Kaoru-dev/Wireless-Charging-Car-with-Acoustic-Source-Localization/Circuit/Overall Plan.png

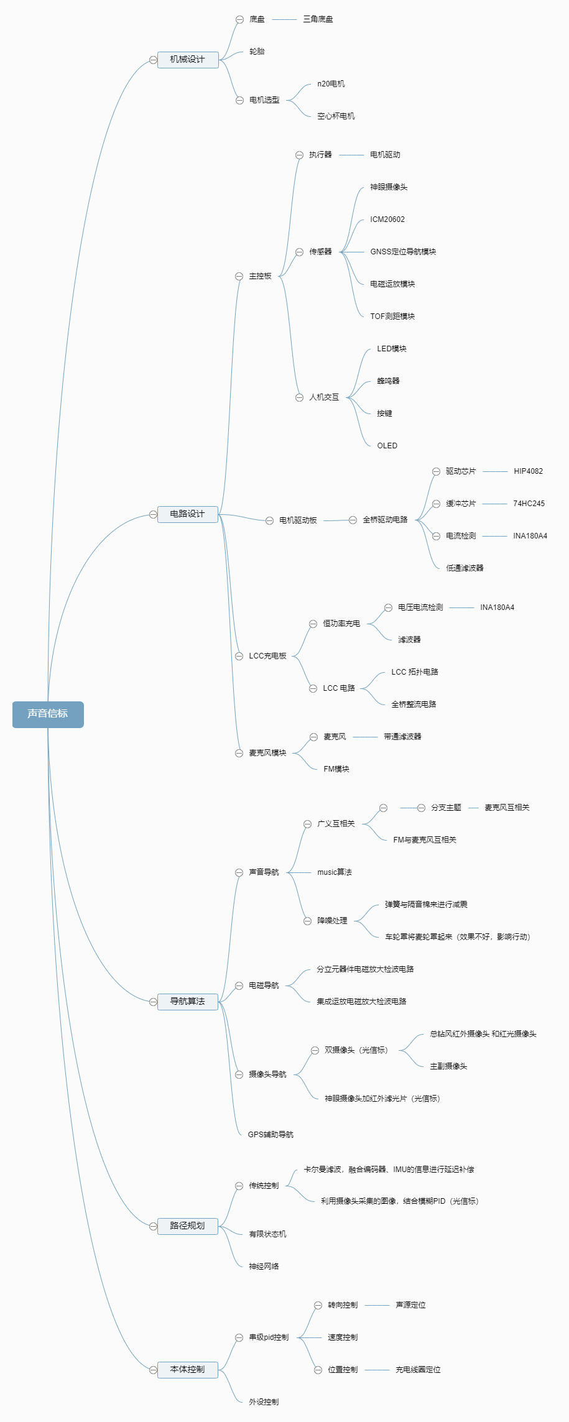
Circuit/Overall Plan.png
