Kaoru-dev/Wireless-Charging-Car-with-Acoustic-Source-Localization/Circuit/Power Tree.jpg

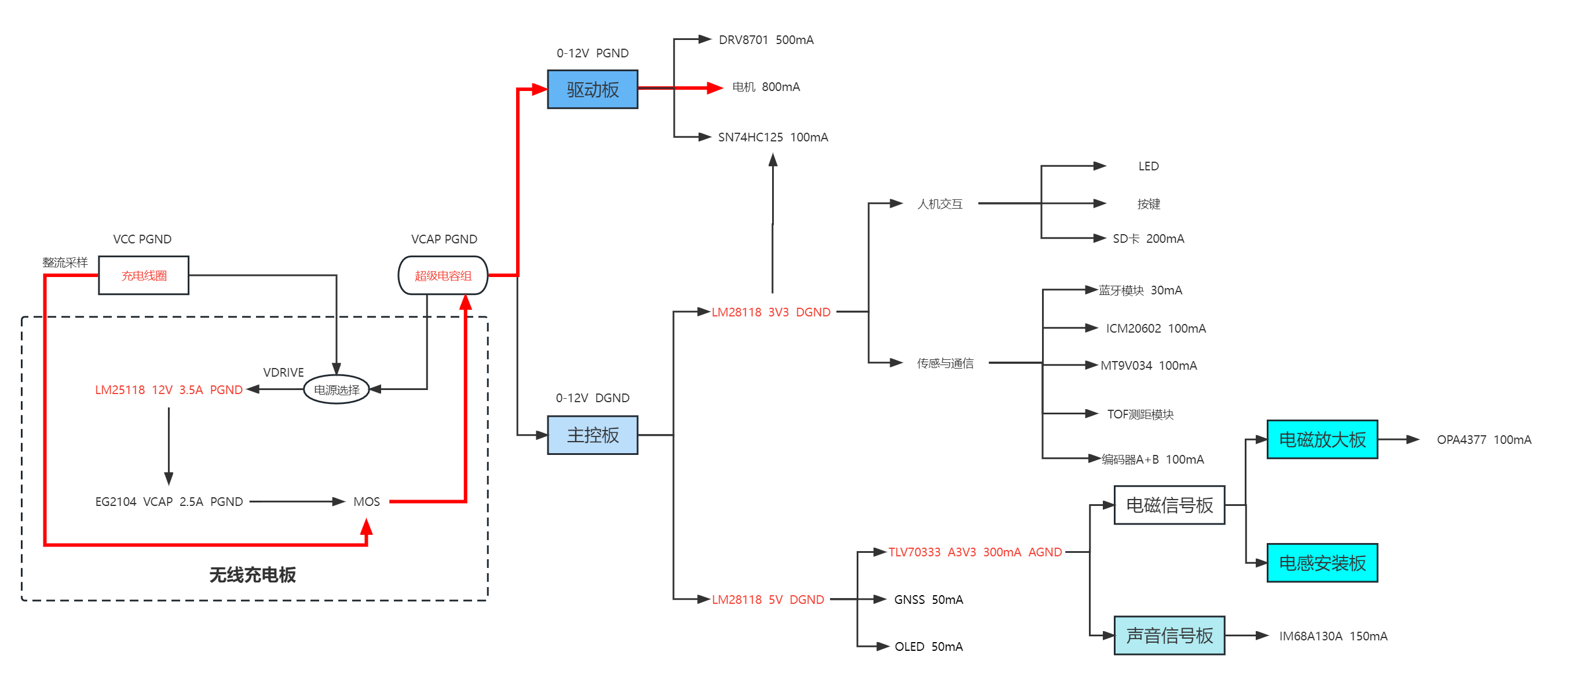
Circuit/Power Tree.jpg
