Kaoru-dev/Wireless-Charging-Car-with-Acoustic-Source-Localization/Circuit/Shopping List.xlsx

序号 | 名称 | 型号 | 数量 | 单价 | 链接
1 | TOF测距模块 | DL1A测距模块 | 1 | 29 | https://m.tb.cn/h.U9poPIz?tk=ThkYd4PU1Mo
2 | 姿态传感器 | ICM20602 | 1 | 44 | https://m.tb.cn/h.Uko7qX3?tk=yhjvd4Pl1Zu
3 | 定位导航模块 | 双频GNSS定位导航模块 | 1 | 102 | https://m.tb.cn/h.U9pCinX?tk=7lQYd4PlLZR
4 | 摄像头 | MT9V034神眼摄像头 | 1 | 236.9 | https://m.tb.cn/h.UQE8dhS?tk=eBLld4PLWfk
5 | 蓝牙模块 | 沁恒USB转蓝牙串口 | 1 | 93.7 | https://m.tb.cn/h.UQEQsiv?tk=FVXjd4PKQzA
6 | 蜂鸣器 | 有源蜂鸣器 | 1 | 2.7 | https://m.tb.cn/h.UQE9Hgt?tk=DK0fd4PqPnV
7 | OLED | 3V3黄蓝OLED模块 | 1 | 27.7 | https://m.tb.cn/h.UQYiOSg?tk=ajaHd4PJ3u1
8 | 电机套装 | 直流霍尔编码减速电机 | 2 | 38 | https://m.tb.cn/h.UkoLofJ?tk=c3Kbd4PsRHU
9 | 编码器 | 龙邱512线mini编码器 | 2 | 170.8 | https://m.tb.cn/h.UQY9usL?tk=fcwld4PHyrk
