Kaoru-dev/Wireless-Charging-Car-with-Acoustic-Source-Localization/Circuit/Wiring Diagram.jpg

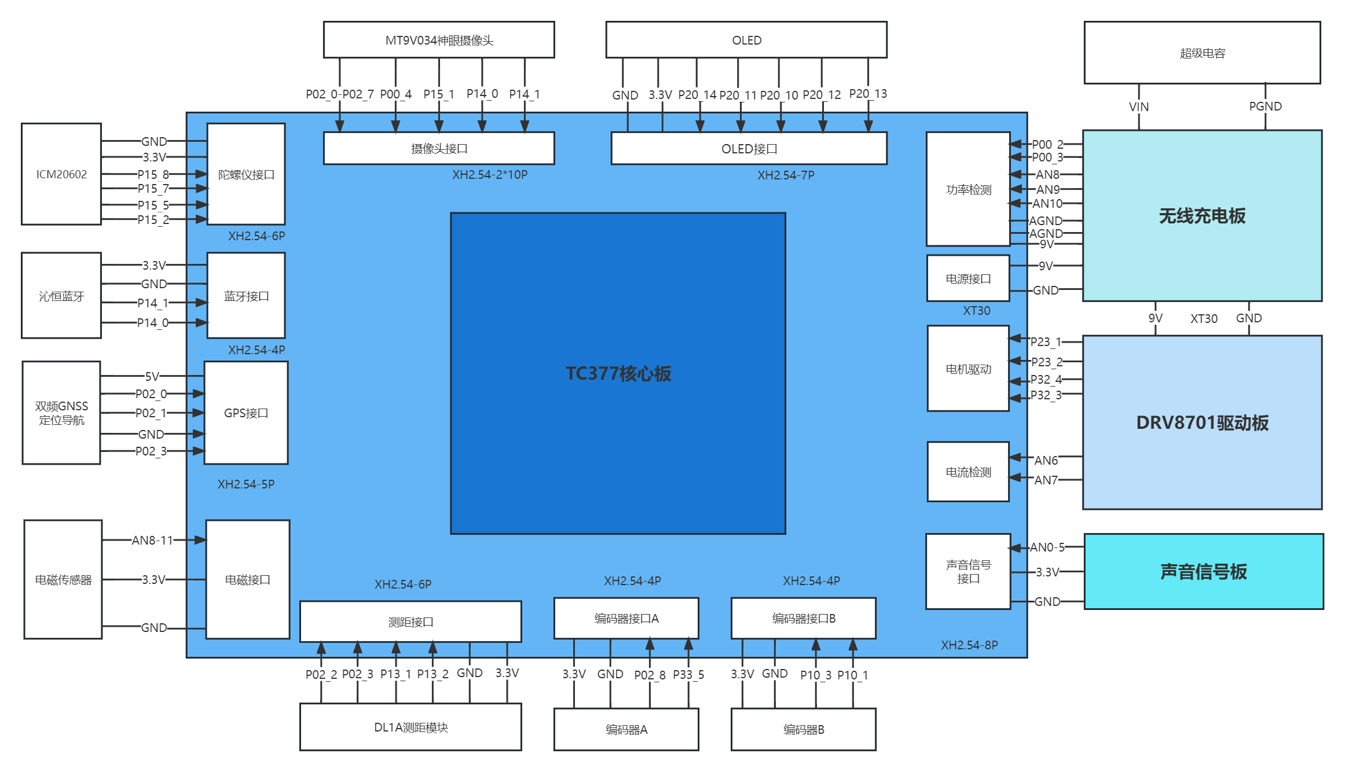
Circuit/Wiring Diagram.jpg
