Kaoru-dev/Wireless-Charging-Car-with-Acoustic-Source-Localization/(list of files, drawings)

Other design files:
Circuit/Circuit Design/Charging circuit board/Beacon_Receive.PcbLib
Circuit/Circuit Design/Charging circuit board/Beacon_Receive.SchLib
Circuit/Circuit Design/Charging circuit board/Constant Power Charging Board/Constant Power Charging Board 4.5.PcbDoc
Circuit/Circuit Design/Charging circuit board/Constant Power Charging Board/Constant Power Charging Board 4.5.SchDoc
Circuit/Circuit Design/Charging circuit board/Constant Power Charging Board/Constant Power Charging Board.PcbLib
Circuit/Circuit Design/Charging circuit board/Constant Power Charging Board/Constant Power Charging Board.SchLib
Circuit/Circuit Design/Charging circuit board/LCC Resonant Charging Board/LCC Resonant Charging Board.PcbDoc
Circuit/Circuit Design/Charging circuit board/LCC Resonant Charging Board/LCC Resonant Charging Board.SchDoc
Circuit/Circuit Design/Controller-Driver Integrated Board/Controller-Driver Integrated Board/Controller-Driver Integrated Board.PrjPcb
Circuit/Circuit Design/Controller-Driver Integrated Board/Integrated_Main_Driver_Board 1.5.SchDoc
Circuit/Circuit Design/Controller-Driver Integrated Board/Integrated_Main_Driver_Board-01-Minimum System Circuit-20230110.SchDoc
Circuit/Circuit Design/Controller-Driver Integrated Board/Integrated_Main_Driver_Board-02-Sensor Circuit-20230110.SchDoc
Circuit/Circuit Design/Controller-Driver Integrated Board/Integrated_Main_Driver_Board-03-Motor Driver Circuit-20230110.SchDoc
Circuit/Circuit Design/Controller-Driver Integrated Board/Integrated_Main_Driver_Board-04-Debug & Communication Circuit-20230110.SchDoc
Circuit/Circuit Design/Controller-Driver Integrated Board/Integrated_Main_Driver_Board-05-Wireless Charging Circuit-20230110.SchDoc
Circuit/Circuit Design/Controller-Driver Integrated Board/Integrated_Main_Driver_Board-06-Power Supply Circuit -20230110.SchDoc
Circuit/Circuit Design/Controller-Driver Integrated Board/Main Control Board.PcbLib
Circuit/Circuit Design/Controller-Driver Integrated Board/Main Control Board.SchLib
Circuit/Circuit Design/Electromagnetic navigation circuit board/Electromagnetic Detection Board/Electromagnetic Detection Board.PcbDoc
Circuit/Circuit Design/Electromagnetic navigation circuit board/Electromagnetic Detection Board/Electromagnetic Detection Board.SchDoc
Circuit/Circuit Design/Electromagnetic navigation circuit board/Electromagnetic Op-Amp Board/Electromagnetic Op-Amp Board.PcbDoc
Circuit/Circuit Design/Electromagnetic navigation circuit board/Electromagnetic Op-Amp Board/Electromagnetic Op-Amp Board.PcbLib
Circuit/Circuit Design/Electromagnetic navigation circuit board/Electromagnetic Op-Amp Board/Electromagnetic Op-Amp Board.SchDoc
Circuit/Circuit Design/Electromagnetic navigation circuit board/Electromagnetic Op-Amp Board/Electromagnetic Op-Amp Board.SchLib
Circuit/Circuit Design/Power supply circuit board/3V-16V to 5V3A DC-DC Converter/3V-16V to 5V3A DC-DC Converter.PcbDoc
Circuit/Circuit Design/Power supply circuit board/3V-16V to 5V3A DC-DC Converter/3V-16V to 5V3A DC-DC Converter.SchDoc
Circuit/Circuit Design/Power supply circuit board/5V-25V to 12V3A DC-DC Converter/5V-25V to 12V3A DC-DC Converter.PcbDoc
Circuit/Circuit Design/Power supply circuit board/5V-25V to 12V3A DC-DC Converter/5V-25V to 12V3A DC-DC Converter.SchDoc
Circuit/Circuit Design/Sound signal circuit board/Adapter board/Adapter board.PcbDoc
Circuit/Circuit Design/Sound signal circuit board/Adapter board/Adapter board.SchDoc
Circuit/Circuit Design/Sound signal circuit board/MEMS Microphone Module/LQ68A130V1.PcbLib
Circuit/Circuit Design/Sound signal circuit board/MEMS Microphone Module/LQ68A130V1.SCHLIB
Circuit/Circuit Design/Sound signal circuit board/MEMS Microphone Module/MEMS Microphone Module.PcbDoc
Circuit/Circuit Design/Sound signal circuit board/MEMS Microphone Module/MEMS Microphone Module.SchDoc
