Kaoru-dev/Wireless-Charging-Car-with-Acoustic-Source-Localization/Code/src/AppSw/Tricore/APP/LQ_Atom_Motor.h

/*LLLLLLLLLLLLLLLLLLLLLLLLLLLLLLLLLLLLLLLLLLLLLLLLLLLLLLLLLLLLLL
【平    台】北京龙邱智能科技TC3xxxA核心板
【编    写】chiusir
【E-mail】chiusir@163.com
【软件版本】V1.1 版权所有，单位使用请先联系授权
【最后更新】2020年10月28日
【相关信息参考下列地址】
【网    站】http://www.lqist.cn
【淘宝店铺】http://longqiu.taobao.com
------------------------------------------------
【dev.env.】AURIX Development Studio1.2.2及以上版本
【Target 】 TC3xxxA
【Crystal】 20.000Mhz
【SYS PLL】 300MHz
________________________________________________________________
基于iLLD_1_0_1_11_0底层程序,
使用例程的时候，建议采用没有空格的英文路径，
=================================================================
程序配套视频地址：https://space.bilibili.com/95313236
QQQQQQQQQQQQQQQQQQQQQQQQQQQQQQQQQQQQQQQQQQQQQQQQQQQQQQQQQQQQQQQ*/
#ifndef __LQ_MT_H_
#define __LQ_MT_H_

#define ATOMSERVO1       IfxGtm_ATOM2_0_TOUT32_P33_10_OUT
#define ATOMSERVO2       IfxGtm_ATOM2_5_TOUT35_P33_13_OUT

//#define ATOMPWM0Pin         IfxGtm_ATOM0_2_TOUT107_P10_5_OUT //定义PWM输出管脚，通过P10.5输出PWM控制蓝灯呼吸
#define ATOMPWM0         IfxGtm_ATOM0_6_TOUT42_P23_1_OUT
#define ATOMPWM1         IfxGtm_ATOM0_5_TOUT40_P32_4_OUT
#define ATOMPWM2         IfxGtm_ATOM0_0_TOUT53_P21_2_OUT
#define ATOMPWM3         IfxGtm_ATOM0_4_TOUT50_P22_3_OUT
#define ATOMPWM4         IfxGtm_ATOM0_2_TOUT33_P33_11_OUT
//#define ATOMPWM4         IfxGtm_ATOM0_2_TOUT55_P21_4_OUT
#define ATOMPWM5         IfxGtm_ATOM0_1_TOUT54_P21_3_OUT
#define ATOMPWM6         IfxGtm_ATOM0_7_TOUT64_P20_8_OUT
#define ATOMPWM7         IfxGtm_ATOM0_3_TOUT56_P21_5_OUT

void LQ_Atom_Motor_8chPWM(void);
void LQ_ATom_Servo_2chPWM(void);
void LQ_Atom_8chPWM(void);

#endif
