Kaoru-dev/Wireless-Charging-Car-with-Acoustic-Source-Localization/Code/src/AppSw/Tricore/APP/LQ_OLED096.c

/*LLLLLLLLLLLLLLLLLLLLLLLLLLLLLLLLLLLLLLLLLLLLLLLLLLLLLLLLLLLLLL
【平    台】北京龙邱智能科技TC3xxxA核心板
【编    写】chiusir
【E-mail】chiusir@163.com
【软件版本】V1.1 版权所有，单位使用请先联系授权
【最后更新】2020年10月28日
【相关信息参考下列地址】
【网    站】http://www.lqist.cn
【淘宝店铺】http://longqiu.taobao.com
------------------------------------------------
【dev.env.】AURIX Development Studio1.2.2及以上版本
【Target 】 TC3xxxA
【Crystal】 20.000Mhz
【SYS PLL】 300MHz
________________________________________________________________
基于iLLD_1_0_1_11_0底层程序,
使用例程的时候，建议采用没有空格的英文路径，
=================================================================
程序配套视频地址：https://space.bilibili.com/95313236
QQQQQQQQQQQQQQQQQQQQQQQQQQQQQQQQQQQQQQQQQQQQQQQQQQQQQQQQQQQQQQQ*/

#include <LQ_GPIO.h>
#include <LQ_STM.h>
#include <LQ_OLED096.h>
#include "include.h"
//龙邱OLED SPI口模块管脚顺序
#define OLED_CK    P20_14     //OLED CK管脚
#define OLED_DI	   P20_11     //OLED DI管脚
#define OLED_RST   P20_10     //OLED RST管脚
#define OLED_DC	   P20_12     //OLED DC管脚
#define OLED_CS	   P20_13     //OLED CS管脚 默认拉低，可以不用

#define OLED_DC_H  PIN_Write(OLED_DC, 1);
#define OLED_DC_L  PIN_Write(OLED_DC, 0);

#define OLED_RST_H PIN_Write(OLED_RST, 1);
#define OLED_RST_L PIN_Write(OLED_RST, 0);

#define OLED_DI_H  PIN_Write(OLED_DI, 1);
#define OLED_DI_L  PIN_Write(OLED_DI, 0);

#define OLED_CK_H  PIN_Write(OLED_CK, 1);
#define OLED_CK_L  PIN_Write(OLED_CK, 0);


#define X_WIDTH 132
#define Y_WIDTH 64

/*!
  * @brief    OLED初始化
  *
  * @param    无
  *
  * @return   无
  *
  * @note     如果修改管脚 需要修改初始化的管脚 
  *
  * @see      OLED_Init();
  *
  * @date     2019/6/13 星期四
  */
void OLED_Init(void)
{ 
    PIN_InitConfig(OLED_DC, PIN_MODE_OUTPUT, 0);
    PIN_InitConfig(OLED_RST, PIN_MODE_OUTPUT, 0);
	PIN_InitConfig(OLED_DI, PIN_MODE_OUTPUT, 0);
	PIN_InitConfig(OLED_CK, PIN_MODE_OUTPUT, 0);
	PIN_InitConfig(OLED_CS, PIN_MODE_OUTPUT, 0);
    
	OLED_CK_H;
    //OLED_CS=1;	//预制SLK和SS为高电平
	OLED_RST_L;
    delayms(50);
    OLED_RST_H;
    
    OLED_WrCmd(0xae);//--turn off oled panel
    OLED_WrCmd(0x00);//---set low column address
    OLED_WrCmd(0x10);//---set high column address
    OLED_WrCmd(0x40);//--set start line address  Set Mapping RAM Display Start Line (0x00~0x3F)
    OLED_WrCmd(0x81);//--set contrast control register
    OLED_WrCmd(0xcf); // Set SEG Output Current Brightness
    OLED_WrCmd(0xa1);//--Set SEG/Column Mapping     0xa0左右反置 0xa1正常
    OLED_WrCmd(0xc8);//Set COM/Row Scan Direction   0xc0上下反置 0xc8正常
    OLED_WrCmd(0xa6);//--set normal display
    OLED_WrCmd(0xa8);//--set multiplex ratio(1 to 64)
    OLED_WrCmd(0x3f);//--1/64 duty
    OLED_WrCmd(0xd3);//-set display offset	Shift Mapping RAM Counter (0x00~0x3F)
    OLED_WrCmd(0x00);//-not offset
    OLED_WrCmd(0xd5);//--set display clock divide ratio/oscillator frequency
    OLED_WrCmd(0x80);//--set divide ratio, Set Clock as 100 Frames/Sec
    OLED_WrCmd(0xd9);//--set pre-charge period
    OLED_WrCmd(0xf1);//Set Pre-Charge as 15 Clocks & Discharge as 1 Clock
    OLED_WrCmd(0xda);//--set com pins hardware configuration
    OLED_WrCmd(0x12);
    OLED_WrCmd(0xdb);//--set vcomh
    OLED_WrCmd(0x40);//Set VCOM Deselect Level
    OLED_WrCmd(0x20);//-Set Page Addressing Mode (0x00/0x01/0x02)
    OLED_WrCmd(0x02);//
    OLED_WrCmd(0x8d);//--set Charge Pump enable/disable
    OLED_WrCmd(0x14);//--set(0x10) disable
    OLED_WrCmd(0xa4);// Disable Entire Display On (0xa4/0xa5)
    OLED_WrCmd(0xa6);// Disable Inverse Display On (0xa6/a7)
    OLED_WrCmd(0xaf);//--turn on oled panel
    OLED_CLS();      //初始清屏
    OLED_Set_Pos(0,0);
    
} 
/** 6*8字库  */
const unsigned char F6x8[][6] =
{
    { 0x00, 0x00, 0x00, 0x00, 0x00, 0x00 },   // sp
    { 0x00, 0x00, 0x00, 0x2f, 0x00, 0x00 },   // !
    { 0x00, 0x00, 0x07, 0x00, 0x07, 0x00 },   // "
    { 0x00, 0x14, 0x7f, 0x14, 0x7f, 0x14 },   // #
    { 0x00, 0x24, 0x2a, 0x7f, 0x2a, 0x12 },   // $
    { 0x00, 0x62, 0x64, 0x08, 0x13, 0x23 },   // %
    { 0x00, 0x36, 0x49, 0x55, 0x22, 0x50 },   // &
    { 0x00, 0x00, 0x05, 0x03, 0x00, 0x00 },   // '
    { 0x00, 0x00, 0x1c, 0x22, 0x41, 0x00 },   // (
    { 0x00, 0x00, 0x41, 0x22, 0x1c, 0x00 },   // )
    { 0x00, 0x14, 0x08, 0x3E, 0x08, 0x14 },   // *
    { 0x00, 0x08, 0x08, 0x3E, 0x08, 0x08 },   // +
    { 0x00, 0x00, 0x00, 0xA0, 0x60, 0x00 },   // ,
    { 0x00, 0x08, 0x08, 0x08, 0x08, 0x08 },   // -
    { 0x00, 0x00, 0x60, 0x60, 0x00, 0x00 },   // .
    { 0x00, 0x20, 0x10, 0x08, 0x04, 0x02 },   // /
    { 0x00, 0x3E, 0x51, 0x49, 0x45, 0x3E },   // 0
    { 0x00, 0x00, 0x42, 0x7F, 0x40, 0x00 },   // 1
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
};

/*!
  * @brief    简单延时函数
  *
  * @param    Del_1ms ：延时时间
  *
  * @return   无
  *
  * @note     无
  *
  * @see      lq_oled_short_delay(1);
  *
  * @date     2019/6/13 星期四
  */
void lq_oled_short_delay(unsigned int Del)	//
{
  while(Del--)
  {
	  __asm("NOP");

  }
}
/*!
  * @brief    OLED画点命令
  *
  * @param    data ：要画的点
  *
  * @return   无
  *
  * @note     无
  *
  * @see      内部调用
  *
  * @date     2019/6/13 星期四
  */
void OLED_WrDat(unsigned char data)
{
    unsigned char i=8;
    //OLED_CS=0;;
    OLED_DC_H;;
    OLED_CK_L;;
    lq_oled_short_delay(1);
    while(i--)
    {
        if(data&0x80){OLED_DI_H;}
        else{OLED_DI_L;}
        OLED_CK_H;
        lq_oled_short_delay(1);
        //asm("nop");            
        OLED_CK_L;
        data<<=1;    
    }
    //OLED_CS=1;
}

/*!
  * @brief    OLED命令
  *
  * @param    cmd ：命令
  *
  * @return   无
  *
  * @note     无
  *
  * @see      内部调用
  *
  * @date     2019/6/13 星期四
  */
void OLED_WrCmd(unsigned char cmd)
{
    unsigned char i=8;
    
    //OLED_CS=0;;
    OLED_DC_L;
    OLED_CK_L;
    lq_oled_short_delay(1);
    while(i--)
    {
        if(cmd&0x80){OLED_DI_H;}
        else{OLED_DI_L;}
        OLED_CK_H;
        lq_oled_short_delay(1);
        OLED_CK_L;
        cmd<<=1;
    } 	
    //OLED_CS=1;
}

/*!
  * @brief    OLED设置点
  *
  * @param    x ：坐标   
  * @param    y ：坐标
  *
  * @return   无
  *
  * @note     左上角为0,0  右下角 127,63
  *
  * @see      内部调用
  *
  * @date     2019/6/13 星期四
  */
void OLED_Set_Pos(unsigned char x, unsigned char y)
{ 
    OLED_WrCmd(0xb0+y);
    OLED_WrCmd(((x&0xf0)>>4)|0x10);
    OLED_WrCmd((x&0x0f));
} 

/*!
  * @brief    OLED全亮
  *
  * @param    无   
  *
  * @return   无
  *
  * @note     无
  *
  * @see      OLED_Fill(); //OLED全亮 用于检测坏点
  *
  * @date     2019/6/13 星期四
  */
void OLED_Fill(void)
{
    unsigned char y,x;
    
    for(y=0;y<8;y++)
    {
        OLED_WrCmd(0xb0+y);
        OLED_WrCmd(0x01);
        OLED_WrCmd(0x10);
        for(x=0;x<X_WIDTH;x++)
            OLED_WrDat(0xff);
    }
}

/*!
  * @brief    OLED清屏
  *
  * @param    无  
  *
  * @return   无
  *
  * @note     无
  *
  * @see      OLED_CLS(); //清屏
  *
  * @date     2019/6/13 星期四
  */
void OLED_CLS(void)
{
    unsigned char y,x;	
    for(y=0;y<8;y++)
    {
        OLED_WrCmd(0xb0+y);
        OLED_WrCmd(0x01);
        OLED_WrCmd(0x10);
        for(x=0;x<X_WIDTH;x++)
            OLED_WrDat(0);
    }
}



/*!
  * @brief    画一个点
  *
  * @param    x  : 0-127 
  * @param    y  : 0-63
  *
  * @return   无
  *
  * @note     OLED是按字节显示的 一个字节8位，代表8个纵向像素点，
  * @note     因此如果画点 OLED_PutPixel(0,0); OLED_PutPixel(0,1); 只会显示点(0, 1) (0,0)则在画点(0,1)时清除掉
  *
  * @see      OLED_PutPixel(0, 0); //画一个点 左上角为0,0  右下角 127,63
  *
  * @date     2019/6/13 星期四
  */
void OLED_PutPixel(unsigned char x,unsigned char y)
{
    unsigned char data1;  //data1当前点的数据 
    
    OLED_Set_Pos(x,(unsigned char)(y>>3));
    data1 =(unsigned char)(0x01<<(y%8)); 	
    OLED_WrCmd((unsigned char)(0xb0+(y>>3)));
    OLED_WrCmd((unsigned char)(((x&0xf0)>>4)|0x10));
    OLED_WrCmd((unsigned char)((x&0x0f)|0x00));
    OLED_WrDat(data1);
}

/*!
  * @brief    清除8个点
  *
  * @param    x  : 0-127
  * @param    y  : 0-63
  *
  * @return   无
  *
  * @note     OLED是按字节显示的 一个字节8位，代表8个纵向像素点，
  *
  * @see      OLED_ClrDot(0, 0); //清除(0,0)-(0,7)8个点 左上角为0,0  右下角 127,63
  *
  * @date     2019/6/13 星期四
  */
void OLED_ClrDot(unsigned char x,unsigned char y)
{
    OLED_Set_Pos(x,(unsigned char)(y>>3));
    OLED_WrCmd((unsigned char)(0xb0+(y>>3)));
    OLED_WrCmd((unsigned char)(((x&0xf0)>>4)|0x10));
    OLED_WrCmd((unsigned char)((x&0x0f)|0x00));
    OLED_WrDat(0x00);
} 


/*!
  * @brief    画矩形
  *
  * @param    x1  : 0-127   左上角坐标（x1,y1）
  * @param    y1  : 0-63
  * @param    x2  : 0-127   右下角坐标（x2，y2）
  * @param    y2  : 0-63
  * @param    gif : 是否开启动画效果
  *
  * @return   无
  *
  * @note     无
  *
  * @see      OLED_Rectangle(0, 0, 127,62,0);   //绘制矩形
  *
  * @date     2019/6/13 星期四
  */
void OLED_Rectangle(unsigned char x1,unsigned char y1,unsigned char x2,unsigned char y2,unsigned char gif)
{	
	unsigned char n; 
    OLED_Set_Pos(x1,y1>>3);
    for(n=x1;n<=x2;n++)
    {
        OLED_WrDat(0x01<<(y1%8));
        if(gif == 1) 	
            delayms(10);
    }  
    OLED_Set_Pos(x1,y2>>3);
    for(n=x1;n<=x2;n++)
    {
        OLED_WrDat(0x01<<(y2%8));
        if(gif == 1) 	
            delayms(10);
    }
    
    for(n = y1>>3; n <= y2>>3; n++)
    {
        OLED_Set_Pos(x1, n);
        OLED_WrDat(0xff);
        if(gif == 1) 	
            delayms(50);
    }
    
    for(n = y1>>3; n <= y2>>3; n++)
    {
        OLED_Set_Pos(x2, n);
        OLED_WrDat(0xff);
        if(gif == 1) 	
            delayms(50);
    }
}  


/*!
  * @brief    写入一组标准ASCII字符串
  *
  * @param    x  : 0-127   
  * @param    y  : 0-7
  * @param    ch : 要显示的字符串
  *
  * @return   无
  *
  * @note     无
  *
  * @see      OLED_P6x8Str(0,0,"OLED 3.");  //显示字符串
  *
  * @date     2019/6/13 星期四
  */
void OLED_P6x8Str(unsigned char x,unsigned char y, char ch[])
{
    unsigned char c=0,i=0,j=0;      
    while (ch[j]!='\0')
    {    
        c =ch[j]-32;
        if(x>126){x=0;y++;}
        OLED_Set_Pos(x,y);
        for(i=0;i<6;i++)     
            OLED_WrDat(F6x8[c][i]);
        x+=6;
        j++;
    }
}

 
/*!
  * @brief    写入一组标准ASCII字符串
  *
  * @param    x  : 0-127   
  * @param    y  : 0-6
  * @param    ch : 要显示的字符串
  *
  * @return   无
  *
  * @note     一个字符高16  OLED高度64  
  *
  * @see      OLED_P8x16Str(0,0,"OLED 3.");  //显示字符串
  *
  * @date     2019/6/13 星期四
  */
void OLED_P8x16Str(unsigned char x,unsigned char y, char ch[])
{
    unsigned char c=0,i=0,j=0;
    
    while (ch[j]!='\0')
    {    
        c =ch[j]-32;
        if(x>120){x=0;y++;}
        OLED_Set_Pos(x,y);
        for(i=0;i<8;i++)     
            OLED_WrDat(F8X16[c*16+i]);
        OLED_Set_Pos(x,y+1);
        for(i=0;i<8;i++)     
            OLED_WrDat(F8X16[c*16+i+8]);
        x+=8;
        j++;
    }
}

/*!
  * @brief    输出汉字字符串
  *
  * @param    x  : 0-127   
  * @param    y  : 0-6
  * @param    ch : 要显示的字符串
  *
  * @return   无
  *
  * @note     一个字符高16  OLED高度64   字库需要自己制作
  *
  * @see      OLED_P14x16Str(0,4,"北京龙邱");   //显示汉字
  *
  * @date     2019/6/13 星期四
  */
void OLED_P14x16Str(unsigned char x,unsigned char y, unsigned char ch[])
{
    unsigned char wm=0,ii = 0;
    unsigned int adder=1; 
    
    while(ch[ii] != '\0')
    {
        wm = 0;
        adder = 1;
        while(F14x16_Idx[wm] > 127)
        {
            if(F14x16_Idx[wm] == (unsigned char)ch[ii])
            {
                if(F14x16_Idx[wm + 1] == ch[ii + 1])
                {
                    adder = wm * 14;
                    break;
                }
            }
            wm += 2;			
        }
        if(x>118){x=0;y++;}
        OLED_Set_Pos(x , y);
        if(adder != 1)// 显示汉字					
        {
            OLED_Set_Pos(x , y);
            for(wm = 0;wm < 14;wm++)               
            {
                OLED_WrDat(F14x16[adder]);
                adder += 1;
            }      
            OLED_Set_Pos(x,y + 1);
            for(wm = 0;wm < 14;wm++)          
            {
                OLED_WrDat(F14x16[adder]);
                adder += 1;
            }   		
        }
        else			  //显示空白字符			
        {
            ii += 1;
            OLED_Set_Pos(x,y);
            for(wm = 0;wm < 16;wm++)
            {
                OLED_WrDat(0);
            }
            OLED_Set_Pos(x,y + 1);
            for(wm = 0;wm < 16;wm++)
            {   		
                OLED_WrDat(0);
            }
        }
        x += 14;
        ii += 2;
    }
}



/*!
  * @brief    显示BMP图片 最大 128×64
  *
  * @param    x0  : 0-127   左上角坐标（x0,y0）
  * @param    y0  : 0-63
  * @param    wide: 1-127   图片宽度
  * @param    high: 1-64    图片高度
  * @param    bmp : 要显示的图片
  *
  * @return   无
  *
  * @note     图片需要用软件转化
  *
  * @see      OLED_Show_BMP(0, 0, 104, 64, longqiu104x64); //画龙邱loge
  *
  * @date     2019/6/13 星期四
  */
void OLED_Show_BMP(unsigned char x0,unsigned char y0,unsigned char wide,unsigned char high,const unsigned char * bmp)
{ 	
    unsigned int ii=0;
    unsigned char x,y;
	unsigned char x1,y1;
	if(wide + x0 > 128 || high + y0 > 64)
	{
		return;  //超出显示范围
	}
	y1 = (y0+high-1)/8;
	x1 = x0 + wide;
    for(y=y0/8;y<=y1;y++)
    {
        OLED_Set_Pos(x0,y);
        for(x=x0;x<x1;x++)
        {      
            OLED_WrDat(bmp[ii++]);
        }
    }
}

/*!
  * @brief    显示龙邱图片128×64
  *
  * @param    无 
  *
  * @return   无
  *
  * @note     无
  *
  * @see      OLED_Show_LQLogo();
  *
  * @date     2019/6/13 星期四
  */
void OLED_Show_LQLogo(void)
{ 	
    unsigned int ii=0;
    unsigned char x,y;       
    
    for(y=0;y<8;y++)
    {
        OLED_Set_Pos(16,y);
        for(x=14;x<118;x++)
        {      
            OLED_WrDat(longqiu104x64[ii++]);
        }
    }
}




/*!
  * @brief    画边线 OV7725显示图像时 可以用这个画边线
  *
  * @param    无 
  *
  * @return   无
  *
  * @note     无
  *
  * @see      OLED_Show_Frame80();
  *
  * @date     2019/6/13 星期四
  */
void OLED_Show_Frame80(void)
{ 	
    
    OLED_Set_Pos(23,1);
    OLED_WrDat(0xFF);
    OLED_Set_Pos(23,2);
    OLED_WrDat(0xFF);
    OLED_Set_Pos(23,3);
    OLED_WrDat(0xFF);
    OLED_Set_Pos(23,4);
    OLED_WrDat(0xFF);
    OLED_Set_Pos(23,5);
    OLED_WrDat(0xFF);
    OLED_Set_Pos(23,6);
    OLED_WrDat(0xFF);
    OLED_Set_Pos(23,7);
    OLED_WrDat(0xFF);
    
    OLED_Set_Pos(104,1);
    OLED_WrDat(0xFF);
    OLED_Set_Pos(104,2);
    OLED_WrDat(0xFF);
    OLED_Set_Pos(104,3);
    OLED_WrDat(0xFF);
    OLED_Set_Pos(104,4);
    OLED_WrDat(0xFF);
    OLED_Set_Pos(104,5);
    OLED_WrDat(0xFF);
    OLED_Set_Pos(104,6);
    OLED_WrDat(0xFF);
    OLED_Set_Pos(104,7);
    OLED_WrDat(0xFF);
}

/*!
  * @brief    画边线 MT9V034显示图像时 可以用这个画边线
  *
  * @param    无 
  *
  * @return   无
  *
  * @note     无
  *
  * @see      OLED_Show_Frame94();
  *
  * @date     2019/6/13 星期四
  */
void OLED_Show_Frame94(void)
{ 	
    //OLED_Set_Pos(13,0);//第0行，第13列
    //OLED_WrDat(0xFF); //画竖线
    OLED_Set_Pos(16,1);
    OLED_WrDat(0xFF);
    OLED_Set_Pos(16,2);
    OLED_WrDat(0xFF);
    OLED_Set_Pos(16,3);
    OLED_WrDat(0xFF);
    OLED_Set_Pos(16,4);
    OLED_WrDat(0xFF);
    OLED_Set_Pos(16,5);
    OLED_WrDat(0xFF);
    OLED_Set_Pos(16,6);
    OLED_WrDat(0xFF);
    OLED_Set_Pos(16,7);
    OLED_WrDat(0xFF);
    
    //OLED_Set_Pos(114,0);
    //OLED_WrDat(0xFF);
    OLED_Set_Pos(111,1);
    OLED_WrDat(0xFF);
    OLED_Set_Pos(111,2);
    OLED_WrDat(0xFF);
    OLED_Set_Pos(111,3);
    OLED_WrDat(0xFF);
    OLED_Set_Pos(111,4);
    OLED_WrDat(0xFF);
    OLED_Set_Pos(111,5);
    OLED_WrDat(0xFF);
    OLED_Set_Pos(111,6);
    OLED_WrDat(0xFF);
    OLED_Set_Pos(111,7);
    OLED_WrDat(0xFF);
}

/**
  * @brief    OLED 二值化图像显示
  *
  * @param    high ： 显示图像高度
  * @param    wide ： 显示图像宽度
  * @param    Pixle： 显示图像数据地址
  *
  * @return   无
  *
  * @note     无
  *
  * @see      OLED_Road(OLEDH, OLEDW, (unsigned char *)Pixle);
  *
  * @date     2019/6/25 星期二
  */
void OLED_Road(unsigned short high, unsigned short wide, unsigned char *Pixle)
{ 	 
    unsigned char i = 0, j = 0,temp=0;
    unsigned char wide_start = (128 - wide)/2;
    for(i=0;i<high-7;i+=8)
    {
        
        OLED_Set_Pos(wide_start,i/8+1);
        
        for(j=0;j<wide;j++) 
        { 
            temp=0;
            if(Pixle[(0+i)*wide + j]) temp|=1;
            if(Pixle[(1+i)*wide + j]) temp|=2;
            if(Pixle[(2+i)*wide + j]) temp|=4;
            if(Pixle[(3+i)*wide + j]) temp|=8;
            if(Pixle[(4+i)*wide + j]) temp|=0x10;
            if(Pixle[(5+i)*wide + j]) temp|=0x20;
            if(Pixle[(6+i)*wide + j]) temp|=0x40;
            if(Pixle[(7+i)*wide + j]) temp|=0x80;
            OLED_WrDat(temp);
        }
    }  
}



/**
  * @brief    OLED 测试函数
  *
  * @param    无
  *
  * @return   无
  *
  * @note     无
  *
  * @example  Test_OLED();
  *
  * @date     2019/6/25 星期二
  */
void Test_OLED(void)
{      
    OLED_Init();                          //OLED初始化
    OLED_Show_LQLogo();                   //显示LOGO
    delayms(2000);
    OLED_CLS();
  
    while (1)
    {  
        OLED_P6x8Str(0,7,"OLED 3.");         //字符串
		delayms(1000);
        OLED_Rectangle(0, 0, 127,62,0);      //绘制矩形
        OLED_Rectangle(24,8,88,55,1);
		OLED_Rectangle(32,16,80,47,1);
		OLED_Rectangle(40,24,72,39,1);
        delayms(1000);
        OLED_CLS();                          //清屏
        
        OLED_P8x16Str(0, 0,"OLED 4.");       //显示字符串
        OLED_P14x16Str(0,4,(unsigned char*)"北京龙邱");      //显示汉字
        OLED_PutPixel(120,60);
        delayms(1000);
        OLED_CLS();                          //清屏
        
        OLED_Fill();                         //填充
        delayms(1000);
        OLED_CLS();                          //清屏
        
        //延时
        delayms(50);
    }
}


/*
 *  float   speedGiaP           = 50;
    float   speedGiaD           = 0;
    float   speedGiaI           = 30;
    float   currentKP1          = 3;        //电流环KP
    float   currentKD1          = 0;           //电流环KD
    float   currentKI1          = 0.1;         //电流环KI
 */
void MY_oled(){//KEY0上用于mode ，key1用于加减
    static  uint8 count=0;
    //sprintf(txt, "%f ", eulerAngle.yaw );  // *3.3/4095
char txt[20];
    if(KEY_Read(KEY0)==0){
        count++;
    if(count==14)
        count=0;
    delayms(200);
    }     //显示字符串

switch(count){
  // case 0:if(KEY_Read(KEY1)==0)Charge_Flag=!Charge_Flag;delayms(100);break;
//   case 0:if(KEY_Read(KEY1)==0) currentDesired1=currentDesired1+10;delayms(100);break;
//    case 1:if(KEY_Read(KEY1)==0)currentDesired1=currentDesired1-10;delayms(100);break;
//    case 0:if(KEY_Read(KEY1)==0) Charge_Flag_start=!Charge_Flag_start;delayms(500);break;
//    case 1:if(KEY_Read(KEY1)==0)Charge_Flag_start=!Charge_Flag_start;delayms(500);break;
    case 2:if(KEY_Read(KEY1)==0)speedGiaP++;delayms(100);break;
    case 3:if(KEY_Read(KEY1)==0)speedGiaP--;delayms(100);break;
    case 4:if(KEY_Read(KEY1)==0)speedGiaI=speedGiaI+0.1;delayms(100);break;
    case 5:if(KEY_Read(KEY1)==0)speedGiaI=speedGiaI-0.1;delayms(100);break;
    case 6:if(KEY_Read(KEY1)==0)speedGiaD++;delayms(100);break;
    case 7:if(KEY_Read(KEY1)==0)speedGiaD--;delayms(100);break;
    case 8:if(KEY_Read(KEY1)==0)currentKP1=currentKP1+0.1;  delayms(100);break;
    case 9:if(KEY_Read(KEY1)==0)currentKP1=currentKP1-0.1;  delayms(100);break;
    case 10:if(KEY_Read(KEY1)==0)currentKI1=currentKI1+0.01; delayms(100);break;
    case 11:if(KEY_Read(KEY1)==0)currentKI1=currentKI1-0.01; delayms(100);break;
    case 12:if(KEY_Read(KEY1)==0)currentKD1=currentKD1+0.1; delayms(100);break;
    case 13:if(KEY_Read(KEY1)==0)currentKD1=currentKD1-0.1; delayms(100);break;

}
    sprintf(txt, "mode %d ", Charge_Flag_start);  // *3.3/4095
    OLED_P8x16Str(0,0,txt);
//   sprintf(txt, "char %d ", Charge_Flag);  // *3.3/4095
//    OLED_P8x16Str(0,0,txt);
    sprintf(txt, "sSet %d ", speedSet_left);  // *3.3/4095
    OLED_P8x16Str(64,0,txt);
    sprintf(txt, "sP %3.1f ", speedGiaP);  // *3.3/4095
    OLED_P8x16Str(0,2,txt);
    sprintf(txt, "sI %3.1f ", speedGiaI);  // *3.3/4095
    OLED_P8x16Str(64,2,txt);
    sprintf(txt, "sD %3.1f ", speedGiaD);  // *3.3/4095
    OLED_P8x16Str(0,4,txt);
    sprintf(txt, "cp %3.1f ", currentKP1);  // *3.3/4095
    OLED_P8x16Str(64,4,txt);
    sprintf(txt, "cI %3.2f ", currentKI1);  // *3.3/4095
    OLED_P8x16Str(0,6,txt);
    sprintf(txt, "cD %3.1f ", currentKD1);  // *3.3/4095
    OLED_P8x16Str(64,6,txt);
}
