Kaoru-dev/Wireless-Charging-Car-with-Acoustic-Source-Localization/Code/src/AppSw/Tricore/APP/LQ_I2C_MPU6050.c

/*LLLLLLLLLLLLLLLLLLLLLLLLLLLLLLLLLLLLLLLLLLLLLLLLLLLLLLLLLLLLLL
【平    台】北京龙邱智能科技TC3xxxA核心板
【编    写】chiusir
【E-mail】chiusir@163.com
【软件版本】V1.1 版权所有，单位使用请先联系授权
【最后更新】2020年10月28日
【相关信息参考下列地址】
【网    站】http://www.lqist.cn
【淘宝店铺】http://longqiu.taobao.com
------------------------------------------------
【dev.env.】AURIX Development Studio1.2.2及以上版本
【Target 】 TC3xxxA
【Crystal】 20.000Mhz
【SYS PLL】 300MHz
________________________________________________________________
基于iLLD_1_0_1_11_0底层程序,
使用例程的时候，建议采用没有空格的英文路径，
=================================================================
程序配套视频地址：https://space.bilibili.com/95313236
QQQQQQQQQQQQQQQQQQQQQQQQQQQQQQQQQQQQQQQQQQQQQQQQQQQQQQQQQQQQQQQ*/

#include <LQ_I2C_MPU6050.h>
#include <LQ_OLED096.h>
#include <LQ_SOFTI2C.h>
#include <LQ_STM.h>
#include <Platform_Types.h>
#include <stdio.h>

/**
  * @brief    读取MPU6050或者ICM20602原始数据 测试
  *
  * @param
  *
  * @return
  *
  * @note
  *
  * @see      Test_MPU6050();
  *
  * @date     2019/6/12 星期三
  */
void Test_MPU6050(void)
{
	char  txt[30];
	signed short  aacx,aacy,aacz;	         //加速度传感器原始数据
	signed short  gyrox,gyroy,gyroz;          //陀螺仪原始数据

    OLED_Init();                          //LCD初始化
    OLED_CLS();                           //LCD清屏
	IIC_Init();

	OLED_P8x16Str(15,0,"LQ 6050 Test");

	if(MPU6050_Init())
    {
        OLED_P8x16Str(15,2,"6050 Test Fail \r\n");
#pragma warning 557         // 屏蔽警告
		while (1);
#pragma warning default     // 打开警告
    }

	while(1)
    {
        MPU_Get_Raw_data(&aacx,&aacy,&aacz,&gyrox,&gyroy,&gyroz);	//得到加速度传感器数据
        sprintf((char*)txt,"ax:%06d",aacx);
        OLED_P6x8Str(0,2,txt);
        sprintf((char*)txt,"ay:%06d",aacy);
        OLED_P6x8Str(0,3,txt);
        sprintf((char*)txt,"az:%06d",aacz);
        OLED_P6x8Str(0,4,txt);
        sprintf((char*)txt,"gx:%06d",gyrox);
        OLED_P6x8Str(0,5,txt);
        sprintf((char*)txt,"gy:%06d",gyroy);
        OLED_P6x8Str(0,6,txt);
        sprintf((char*)txt,"gz:%06d",gyroz);
        OLED_P6x8Str(0,7,txt);

        delayms(100);

    }

}

/**
  * @brief    不精确延时
  *
  * @param    无
  *
  * @return   无
  *
  * @note     无
  *
  * @see      delayms_mpu(100);
  *
  * @date     2019/4/22 星期一
*/
void delayms_mpu(uint16 ms)
{
	while(ms--)
	{
		uint16  i = 300;
		while(i--)
		{
			NOP(50);
		}
	}
}


/**
  * @brief    初始化MPU6050 或者 ICM20602
  *
  * @param    无
  *
  * @return   0：初始化成功   1：失败
  *
  * @note     使用前先初始化IIC接口
  *
  * @see      MPU6050_Init();
  *
  * @date     2019/6/12 星期三
  */
unsigned char MPU6050_Init(void)
{
    int  res;
    res = MPU_Read_Byte(MPU6050_ADDR,WHO_AM_I);           //读取MPU6050的ID
    if(res == MPU6050_ID)                                 //器件ID正确
    {
        //printf("MPU6050 is OK!\r\n");
    }
    else if(res == 0x12)                                  //ICM20602 器件ID正确
    {

        //printf("ICM20602 is OK!\r\n");
    }
    else
    {
        //printf("\r\nThe correct IMU was not detected\r\nPlease check the wiring ID=%X\r\n",res);
        return 1;
    }

    res = 0;
    res += MPU_Write_Byte(MPU6050_ADDR,MPU_PWR_MGMT1_REG,0X80);//复位MPU6050
    delayms_mpu(100);  //延时100ms
    res += MPU_Write_Byte(MPU6050_ADDR,MPU_PWR_MGMT1_REG,0X00);//唤醒MPU6050
    res += MPU_Set_Gyro_Fsr(3);					        	   //陀螺仪传感器,±2000dps
    res += MPU_Set_Accel_Fsr(1);					       	   //加速度传感器,±4g
    res += MPU_Set_Rate(1000);						       	   //设置采样率1000Hz
    res += MPU_Write_Byte(MPU6050_ADDR,MPU_CFG_REG,0x02);      //设置数字低通滤波器   98hz
    res += MPU_Write_Byte(MPU6050_ADDR,MPU_INT_EN_REG,0X00);   //关闭所有中断
    res += MPU_Write_Byte(MPU6050_ADDR,MPU_USER_CTRL_REG,0X00);//I2C主模式关闭
    res += MPU_Write_Byte(MPU6050_ADDR,MPU_PWR_MGMT1_REG,0X01);//设置CLKSEL,PLL X轴为参考
    res += MPU_Write_Byte(MPU6050_ADDR,MPU_PWR_MGMT2_REG,0X00);//加速度与陀螺仪都工作

    if(res == 0)  //上面寄存器都写入成功
    {
        //printf("MPU set is OK!\r\n");
    }
    else return 1;

    return 0;
}




/**
  * @brief    设置陀螺仪测量范围
  *
  * @param    fsr:0,±250dps;1,±500dps;2,±1000dps;3,±2000dps
  *
  * @return   0 ：设置成功
  *
  * @note     无
  *
  * @see      MPU_Set_Gyro_Fsr(3);		  //陀螺仪传感器,±2000dps
  *
  * @date     2019/6/12 星期三
  */
unsigned char MPU_Set_Gyro_Fsr(unsigned char fsr)
{
	return MPU_Write_Byte(MPU6050_ADDR,MPU_GYRO_CFG_REG,fsr<<3);
}



/**
  * @brief    设置加速度计测量范围
  *
  * @param    fsr:0,±2g;1,±4g;2,±8g;3,±16g
  *
  * @return   0：设置成功
  *
  * @note     无
  *
  * @see      MPU_Set_Accel_Fsr(1);		  //加速度传感器,±4g
  *
  * @date     2019/6/12 星期三
  */
unsigned char MPU_Set_Accel_Fsr(unsigned char fsr)
{
	return MPU_Write_Byte(MPU6050_ADDR,MPU_ACCEL_CFG_REG,fsr<<3);
}



/**
  * @brief    设置数字低通滤波
  *
  * @param    lpf:数字低通滤波频率(Hz)
  *
  * @return   0：设置成功
  *
  * @note     无
  *
  * @see      MPU_Set_LPF(100);
  *
  * @date     2019/6/12 星期三
  */
unsigned char MPU_Set_LPF(uint16 lpf)
{
	unsigned char  dat=0;
	if(lpf>=188)dat=1;
	else if(lpf>=98)dat=2;
	else if(lpf>=42)dat=3;
	else if(lpf>=20)dat=4;
	else if(lpf>=10)dat=5;
	else dat=6;
	return MPU_Write_Byte(MPU6050_ADDR,MPU_CFG_REG,dat);//设置数字低通滤波器
}




/**
  * @brief    设置采样率
  *
  * @param    rate:4~1000(Hz)
  *
  * @return   0：设置成功
  *
  * @note     无
  *
  * @see      MPU_Set_Rate(1000);       	   //设置采样率1000Hz
  *
  * @date     2019/6/12 星期三
  */
unsigned char MPU_Set_Rate(uint16 rate)
{
	unsigned char  dat;
	if(rate>1000)rate=1000;
	if(rate<4)rate=4;
	dat=1000/rate-1;
	MPU_Write_Byte(MPU6050_ADDR,MPU_SAMPLE_RATE_REG,dat);	    //设置数字低通滤波器
 	return MPU_Set_LPF(rate/2);	                                //自动设置LPF为采样率的一半
}



/**
  * @brief    获取温度值
  *
  * @param    无
  *
  * @return   温度值(扩大了100倍)
  *
  * @note     无
  *
  * @see      signed short temp = MPU_Get_Temperature();
  *
  * @date     2019/6/12 星期三
  */
short MPU_Get_Temperature(void)
{
    unsigned char  buf[2];
    short raw;
	float temp;
	MPU_Read_Len(MPU6050_ADDR,MPU_TEMP_OUTH_REG,2,buf);
    raw=((uint16)buf[0]<<8)|buf[1];
    temp=21+((double)raw)/333.87;
    return (short)temp*100;
}





/**
  * @brief    获取陀螺仪值
  *
  * @param    gx,gy,gz:陀螺仪x,y,z轴的原始读数(带符号)
  *
  * @return   0：读取成功
  *
  * @note     无
  *
  * @see      signed short data[3];
  * @see      MPU_Get_Gyroscope(&data[0], &data[1], &data[2]);
  *
  * @date     2019/6/12 星期三
  */
unsigned char MPU_Get_Gyroscope(signed short *gx,signed short *gy,signed short *gz)
{
    unsigned char  buf[6],res;
	res=MPU_Read_Len(MPU6050_ADDR,MPU_GYRO_XOUTH_REG,6,buf);
	if(res==0)
	{
		*gx=((uint16)buf[0]<<8)|buf[1];
		*gy=((uint16)buf[2]<<8)|buf[3];
		*gz=((uint16)buf[4]<<8)|buf[5];
	}
    return res;
}




/**
  * @brief    获取加速度值
  *
  * @param    ax,ay,az:陀螺仪x,y,z轴的原始读数(带符号)
  *
  * @return   0：读取成功
  *
  * @note     无
  *
  * @see      signed short data[3];
  * @see      MPU_Get_Accelerometer(&data[0], &data[1], &data[2]);
  *
  * @date     2019/6/12 星期三
  */
unsigned char MPU_Get_Accelerometer(signed short *ax,signed short *ay,signed short *az)
{
    unsigned char  buf[6],res;
	res=MPU_Read_Len(MPU6050_ADDR,MPU_ACCEL_XOUTH_REG,6,buf);
	if(res==0)
	{
		*ax=((uint16)buf[0]<<8)|buf[1];
		*ay=((uint16)buf[2]<<8)|buf[3];
		*az=((uint16)buf[4]<<8)|buf[5];
	}
    return res;
}




/**
  * @brief    获取 加速度值 角速度值
  *
  * @param    ax,ay,az:陀螺仪x,y,z轴的原始读数(带符号)
  * @param    gx,gy,gz:陀螺仪x,y,z轴的原始读数(带符号)
  *
  * @return   0：读取成功
  *
  * @note     无
  *
  * @see      signed short data[6];
  * @see      ICM_Get_Raw_data(&data[0], &data[1], &data[2],&data[3], &data[4], &data[5]);
  *
  */
unsigned char MPU_Get_Raw_data(signed short *ax,signed short *ay,signed short *az,signed short *gx,signed short *gy,signed short *gz)
{
    unsigned char  buf[14],res;
	res=MPU_Read_Len(MPU6050_ADDR,MPU_ACCEL_XOUTH_REG,14,buf);
	if(res==0)
	{
		*ax=((uint16)buf[0]<<8)|buf[1];
		*ay=((uint16)buf[2]<<8)|buf[3];
		*az=((uint16)buf[4]<<8)|buf[5];
        *gx=((uint16)buf[8]<<8)|buf[9];
		*gy=((uint16)buf[10]<<8)|buf[11];
		*gz=((uint16)buf[12]<<8)|buf[13];
	}
    return res;
}





/**
  * @brief    IIC 连续读
  *
  * @param    addr:器件地址
  * @param    reg :要读取的寄存器地址
  * @param    len :要读取的长度
  * @param    buf :读取到的数据存储区
  *
  * @return   0 ：读取成功
  *
  * @note     底层驱动 移植时需要修改
  *
  * @see      unsigned char buf[14];
  * @see      MPU_Read_Len(MPU6050_ADDR,MPU_ACCEL_XOUTH_REG,14,buf);
  *
  * @date     2019/6/12 星期三
  */
unsigned char MPU_Read_Len(unsigned char addr,unsigned char reg,unsigned char len,unsigned char *buf)
{
    return IIC_ReadMultByteFromSlave(addr<<1, reg, len, buf);
}



/**
  * @brief    IIC 写一个寄存器
  *
  * @param    addr  :器件地址
  * @param    reg   :寄存器地址
  * @param    value :要写入的值
  *
  * @return   0 ：读取成功
  *
  * @note     底层驱动 移植时需要修改
  *
  * @see      MPU_Write_Byte(MPU6050_ADDR,MPU_SAMPLE_RATE_REG,1);
  *
  * @date     2019/6/12 星期三
  */
unsigned char MPU_Write_Byte(unsigned char addr,unsigned char reg,unsigned char value)
{
    return IIC_WriteByteToSlave(addr<<1, reg, value);
}


/**
  * @brief    IIC 读一个寄存器
  *
  * @param    addr  :器件地址
  * @param    reg   :寄存器地址
  *
  * @return   读取的值
  *
  * @note     底层驱动 移植时需要修改
  *
  * @see      MPU_Read_Byte(MPU6050_ADDR,WHO_AM_I);
  *
  * @date     2019/6/12 星期三
  */
unsigned char MPU_Read_Byte(unsigned char addr,unsigned char reg)
{
    unsigned char value[1];
    MPU_Read_Len(addr, reg, 1, value);
    return value[0];
}
