Kaoru-dev/Wireless-Charging-Car-with-Acoustic-Source-Localization/Code/src/AppSw/Tricore/APP/LQ_ICM20602.c

/*LLLLLLLLLLLLLLLLLLLLLLLLLLLLLLLLLLLLLLLLLLLLLLLLLLLLLLLLLLLLLL
【平    台】北京龙邱智能科技TC3xxxA核心板
【编    写】chiusir
【E-mail】chiusir@163.com
【软件版本】V1.1 版权所有，单位使用请先联系授权
【最后更新】2020年10月28日
【相关信息参考下列地址】
【网    站】http://www.lqist.cn
【淘宝店铺】http://longqiu.taobao.com
------------------------------------------------
【dev.env.】AURIX Development Studio1.2.2及以上版本
【Target 】 TC3xxxA
【Crystal】 20.000Mhz
【SYS PLL】 300MHz
________________________________________________________________
基于iLLD_1_0_1_11_0底层程序,
使用例程的时候，建议采用没有空格的英文路径，
=================================================================
程序配套视频地址：https://space.bilibili.com/95313236
QQQQQQQQQQQQQQQQQQQQQQQQQQQQQQQQQQQQQQQQQQQQQQQQQQQQQQQQQQQQQQQ*/

#include <LQ_ICM20602.h>
#include <LQ_OLED096.h>
#include <LQ_SPI.h>
#include <LQ_QSPI.h>
#include <LQ_STM.h>
#include <Platform_Types.h>
#include <stdio.h>
#include "include.h"
/*!
  * @brief    测试20602 SPI接线方式
  *
  * @param    无
  *
  * @return   无
  *
  * @note     无
  *
  * @see      Test_ICM20602();
  *
  * @date     2019/4/22 星期一
*/
void Test_ICM20602(void)
{
    char  txt[30];
	short aacx,aacy,aacz;	         //加速度传感器原始数据
	short gyrox,gyroy,gyroz;        //陀螺仪原始数据
    OLED_Init();                      //LCD初始化
    OLED_CLS();                       //LCD清屏

    QSPI_InitConfig(QSPI2_CLK_P15_8, QSPI2_MISO_P15_7, QSPI2_MOSI_P15_5, QSPI2_CS_P15_2, 5000000, 3);


    OLED_P8x16Str(15,0,"LQ 20602 Test");


    if(ICM20602_Init())
    {
    	OLED_P8x16Str(15,2,"ICM20602 Test Fail");
#pragma warning 557         // 屏蔽警告
		while (1);
#pragma warning default     // 打开警告
    }

    while(1)
    {
        ICM_Get_Raw_data(&aacx,&aacy,&aacz,&gyrox,&gyroy,&gyroz);	//得到加速度传感器数据
        sprintf((char*)txt,"ax:%06d",aacx);
        UART_PutStr(UART0, txt);
        sprintf((char*)txt,"ay:%06d",aacy);
        UART_PutStr(UART0, txt);
        sprintf((char*)txt,"az:%06d",aacz);
        UART_PutStr(UART0, txt);
        sprintf((char*)txt,"gx:%06d",gyrox);
        UART_PutStr(UART0, txt);
        sprintf((char*)txt,"gy:%06d",gyroy);
        UART_PutStr(UART0, txt);
        sprintf((char*)txt,"gz:%06d",gyroz);
        UART_PutStr(UART0, txt);

        delayms(500);

    }

}


/*!
  * @brief    不精确延时
  *
  * @param    无
  *
  * @return   无
  *
  * @note     无
  *
  * @see      delayms_icm(100);
  *
  * @date     2019/4/22 星期一
*/
void delayms_icm(uint16 ms)
{
	volatile unsigned long i = 0;
	while(ms--)
	{
		for (i = 0; i < 30000; ++i)
		{
			__asm("NOP"); /* delay */
		}
	}
}




/*!
  * @brief    初始化ICM20602 或者 ICM20602
  *
  * @param    无
  *
  * @return   0：初始化成功   1：失败
  *
  * @note     使用SPI接线方式的初始化
  *
  * @see      ICM20602_Init();
  *
  * @date     2019/6/12 星期三
  */
unsigned char ICM20602_Init(void)
{
    unsigned char res;
    res = ICM_Read_Byte(WHO_AM_I);           //读取ICM20602的ID
    if(res == 0x12)                          //器件ID正确
    {
    //    UART_PutStr(UART0, "is OK!");
//        PRINTF("ICM20602 is OK!\n");
    }
    else
    {
//        PRINTF("\r\nThe correct IMU was not detected\r\nPlease check the wiring ID=%X\r\n",res);
        return 1;
    }

    res = 0;
    res += ICM_Write_Byte(ICM_PWR_MGMT1_REG,0X80);//复位ICM20602
    delayms_icm(100);  //延时100ms
    res += ICM_Write_Byte(ICM_PWR_MGMT1_REG,0X00);//唤醒ICM20602
    res += ICM_Set_Gyro_Fsr(3);					  //陀螺仪传感器,±2000dps
    res += ICM_Set_Accel_Fsr(1);				  //加速度传感器,±4g
    res += ICM_Set_Rate(1000);					  //设置采样率1000Hz
    res += ICM_Write_Byte(ICM_CFG_REG,0x02);      //设置数字低通滤波器   98hz
    res += ICM_Write_Byte(ICM_INT_EN_REG,0X00);   //关闭所有中断
    res += ICM_Write_Byte(ICM_USER_CTRL_REG,0X00);//I2C主模式关闭
    res += ICM_Write_Byte(ICM_PWR_MGMT1_REG,0X01);//设置CLKSEL,PLL X轴为参考
    res += ICM_Write_Byte(ICM_PWR_MGMT2_REG,0X00);//加速度与陀螺仪都工作

    if(res == 0)  //上面寄存器都写入成功
    {
//        PRINTF("MPU set is OK!\n");
    }
    else return 1;

    return 0;
}




/*!
  * @brief    设置陀螺仪测量范围
  *
  * @param    fsr:0,±250dps;1,±500dps;2,±1000dps;3,±2000dps
  *
  * @return   0 ：设置成功
  *
  * @note     使用SPI接线方式的初始化
  *
  * @see      ICM_Set_Gyro_Fsr(3);	//陀螺仪传感器,±2000dps
  *
  * @date     2019/6/12 星期三
  */
unsigned char ICM_Set_Gyro_Fsr(unsigned char fsr)
{
	return ICM_Write_Byte(ICM_GYRO_CFG_REG,fsr<<3);
}



/*!
  * @brief    设置加速度计测量范围
  *
  * @param    fsr:0,±2g;  1,±4g;  2,±8g;   3,±16g
  *
  * @return   0：设置成功
  *
  * @note     使用SPI接线方式的初始化
  *
  * @see      ICM_Set_Accel_Fsr(1);				  //加速度传感器,±4g
  *
  * @date     2019/6/12 星期三
  */
unsigned char ICM_Set_Accel_Fsr(unsigned char fsr)
{
	return ICM_Write_Byte(ICM_ACCEL_CFG_REG,fsr<<3);
}



/*!
  * @brief    设置数字低通滤波
  *
  * @param    lpf:数字低通滤波频率(Hz)
  *
  * @return   0：设置成功
  *
  * @note     使用SPI接线方式的初始化
  *
  * @see      ICM_Set_LPF(100); //设置数字低通滤波
  *
  * @date     2019/6/12 星期三
  */
unsigned char ICM_Set_LPF(uint16 lpf)
{
	unsigned char data=0;
	if(lpf>=188)data=1;
	else if(lpf>=98)data=2;
	else if(lpf>=42)data=3;
	else if(lpf>=20)data=4;
	else if(lpf>=10)data=5;
	else data=6;
	return ICM_Write_Byte(ICM_CFG_REG,data);//设置数字低通滤波器
}




/*!
  * @brief    设置采样率
  *
  * @param    rate:4~1000(Hz)
  *
  * @return   0：设置成功
  *
  * @note     使用SPI接线方式的初始化
  *
  * @see      ICM_Set_Rate(1000);		//设置采样率1000Hz
  *
  * @date     2019/6/12 星期三
  */
unsigned char ICM_Set_Rate(uint16 rate)
{
	unsigned char data;
	if(rate>1000)rate=1000;
	if(rate<4)rate=4;
	data=1000/rate-1;
	ICM_Write_Byte(ICM_SAMPLE_RATE_REG,data);	                //设置数字低通滤波器
 	return ICM_Set_LPF(rate/2);	                                //自动设置LPF为采样率的一半
}



/*!
  * @brief    获取温度值
  *
  * @param    无
  *
  * @return   温度值(扩大了100倍)
  *
  * @note     温度值(扩大了100倍)
  *
  * @see      ICM_Get_Temperature();
  *
  * @date     2019/6/12 星期三
  */
short ICM_Get_Temperature(void)
{
    unsigned char buf[3];
    short raw;
	float temp;
	ICM_Read_Len(ICM_TEMP_OUTH_REG,2,buf);
    raw=((uint16)buf[1]<<8)|buf[2];
    temp=21+((double)raw)/333.87;
    return (short)temp*100;
}





/*!
  * @brief    获取陀螺仪值
  *
  * @param    gx,gy,gz:陀螺仪x,y,z轴的原始读数(带符号)
  *
  * @return   0：读取成功
  *
  * @note     无
  *
  * @see      int6_t data[3];
  * @see      ICM_Get_Gyroscope(&data[0], &data[1], &data[2]);
  *
  * @date     2019/6/12 星期三
  */
unsigned char ICM_Get_Gyroscope(short *gx,short *gy,short *gz)
{
    unsigned char buf[7],res;
	res=ICM_Read_Len(ICM_GYRO_XOUTH_REG,6,buf);
	if(res==0)
	{
		*gx=((uint16)buf[1]<<8)|buf[2];
		*gy=((uint16)buf[3]<<8)|buf[4];
		*gz=((uint16)buf[5]<<8)|buf[6];
	}
    return res;
}




/*!
  * @brief    获取加速度值
  *
  * @param    ax,ay,az:陀螺仪x,y,z轴的原始读数(带符号)
  *
  * @return   0：读取成功
  *
  * @note     无
  *
  * @see      int6_t data[3];
  * @see      ICM_Get_Accelerometer(&data[0], &data[1], &data[2]);
  *
  * @date     2019/6/12 星期三
  */
unsigned char ICM_Get_Accelerometer(short *ax,short *ay,short *az)
{
    unsigned char buf[7],res;
	res=ICM_Read_Len(ICM_ACCEL_XOUTH_REG,6,buf);
	if(res==0)
	{
		*ax=((uint16)buf[1]<<8)|buf[2];
		*ay=((uint16)buf[3]<<8)|buf[4];
		*az=((uint16)buf[5]<<8)|buf[6];
	}
    return res;
}




/*!
  * @brief    获取 加速度值 角速度值
  *
  * @param    ax,ay,az:陀螺仪x,y,z轴的原始读数(带符号)
  * @param    gx,gy,gz:陀螺仪x,y,z轴的原始读数(带符号)
  *
  * @return   0：读取成功
  *
  * @note     无
  *
  * @see      int6_t data[6];
  * @see      ICM_Get_Raw_data(&data[0], &data[1], &data[2],&data[3], &data[4], &data[5]);
  *
  * @date     2019/6/12 星期三
  */
unsigned char ICM_Get_Raw_data(short *ax,short *ay,short *az,short *gx,short *gy,short *gz)
{
    unsigned char buf[15],res;
	res=ICM_Read_Len(ICM_ACCEL_XOUTH_REG,14,buf);
	if(res==0)
	{
		*ax=((uint16)buf[1]<<8)|buf[2];
		*ay=((uint16)buf[3]<<8)|buf[4];
		*az=((uint16)buf[5]<<8)|buf[6];
        *gx=((uint16)buf[9]<<8)|buf[10];
		*gy=((uint16)buf[11]<<8)|buf[12];
		*gz=((uint16)buf[13]<<8)|buf[14];
	}
    return res;
}




/*!
  * @brief    SPI 连续读
  *
  * @param    reg :要读取的寄存器地址
  * @param    len :要读取的长度
  * @param    buf :读取到的数据存储区
  *
  * @return   0 ：读取成功
  *
  * @note     底层驱动 移植时需要修改
  *
  * @see      unsigned char buf[15],res;
  * @see      res=ICM_Read_Len(ICM_ACCEL_XOUTH_REG,14,buf);
  *
  * @date     2019/6/12 星期三
  */
unsigned char ICM_Read_Len(unsigned char reg,unsigned char len,unsigned char *buf)
{
    buf[0] = reg | 0x80;

    /* 写入要读的寄存器地址 */
    return QSPI_ReadWriteNByte(QSPI2, buf, buf, len + 1);
}



/*!
  * @brief    SPI 写一个寄存器
  *
  * @param    reg   :要写的寄存器地址
  * @param    value :要写入的值
  *
  * @return   0 ：读取成功
  *
  * @note     底层驱动 移植时需要修改
  *
  * @see      ICM_Write_Byte(ICM_SAMPLE_RATE_REG,1);
  *
  * @date     2019/6/12 星期三
  */
unsigned char ICM_Write_Byte(unsigned char reg,unsigned char value)
{
    unsigned char buff[2];

    buff[0] = reg;          //先发送寄存器
    buff[1] = value;        //再发送数据

    return QSPI_ReadWriteNByte(QSPI2, buff, buff, 2); //发送buff里数据，并采集到 buff里
}

/*!
  * @brief    SPI 读一个寄存器
  *
  * @param    reg   :要写的寄存器地址
  *
  * @return   读取的值
  *
  * @note     底层驱动 移植时需要修改
  *
  * @see      ICM_Read_Byte(WHO_AM_I);
  *
  * @date     2019/6/12 星期三
  */
unsigned char ICM_Read_Byte(unsigned char reg)
{
    unsigned char buff[2];
    buff[0] = reg | 0x80;          //先发送寄存器

    QSPI_ReadWriteNByte(QSPI2, buff, buff, 2);
    return buff[1];
}
