Kaoru-dev/Wireless-Charging-Car-with-Acoustic-Source-Localization/Code/src/AppSw/Tricore/Driver/LQ_GPSR.c

/*LLLLLLLLLLLLLLLLLLLLLLLLLLLLLLLLLLLLLLLLLLLLLLLLLLLLLLLLLLLLLL
【平    台】北京龙邱智能科技TC3xxxA核心板
【编    写】chiusir
【E-mail】chiusir@163.com
【软件版本】V1.1 版权所有，单位使用请先联系授权
【最后更新】2020年10月28日
【相关信息参考下列地址】
【网    站】http://www.lqist.cn
【淘宝店铺】http://longqiu.taobao.com
------------------------------------------------
【dev.env.】AURIX Development Studio1.2.2及以上版本
【Target 】 TC3xxxA
【Crystal】 20.000Mhz
【SYS PLL】 300MHz
________________________________________________________________
基于iLLD_1_0_1_11_0底层程序,
使用例程的时候，建议采用没有空格的英文路径，
=================================================================
程序配套视频地址：https://space.bilibili.com/95313236
 */

#include <IfxInt_reg.h>
#include <IfxCpu_Irq.h>
#include <IfxSrc_reg.h>
#include <LQ_GPSR.h>
#include <Platform_Types.h>
#include "include.h"
/** cpu软件中断优先级 */
const uint8 CpuSoftIrqPriority[12] = {
        CPU0_SOFT_IRQ0_PRIORITY, CPU0_SOFT_IRQ1_PRIORITY, CPU0_SOFT_IRQ2_PRIORITY,CPU0_SOFT_IRQ3_PRIORITY,
        CPU1_SOFT_IRQ0_PRIORITY, CPU1_SOFT_IRQ1_PRIORITY, CPU1_SOFT_IRQ2_PRIORITY,CPU1_SOFT_IRQ3_PRIORITY,
        CPU2_SOFT_IRQ0_PRIORITY, CPU2_SOFT_IRQ1_PRIORITY, CPU2_SOFT_IRQ2_PRIORITY,CPU2_SOFT_IRQ3_PRIORITY
};

/**
 * @brief    CPU0_SOFT_IRQ0Handler中断服务函数
 * @note     cpu0 软件中断0中断服务函数
 */
void CPU0_SOFT_IRQ0Handler (void)
{
    SRC_GPSR00.B.SRR = 0;
    /* 用户代码 */

}

void CPU0_SOFT_IRQ1Handler (void)
{
    SRC_GPSR01.B.SRR = 0;
    /* 用户代码 */
}

void CPU0_SOFT_IRQ2Handler (void)
{
    SRC_GPSR02.B.SRR = 0;
    /* 用户代码 */
}

void CPU0_SOFT_IRQ3Handler (void)
{
    SRC_GPSR03.B.SRR = 0;
    /* 用户代码 */
}

void CPU1_SOFT_IRQ0Handler (void)
{
    SRC_GPSR04.B.SRR = 0;
    /* 用户代码 */
    LED_Ctrl(LEDALL,RVS);
}

void CPU1_SOFT_IRQ1Handler (void)
{
    SRC_GPSR05.B.SRR = 0;
    /* 用户代码 */
    LED_Ctrl(LEDALL,RVS);
}

void CPU1_SOFT_IRQ2Handler (void)
{
    SRC_GPSR06.B.SRR = 0;
    /* 用户代码 */
}

void CPU1_SOFT_IRQ3Handler (void)
{
    SRC_GPSR07.B.SRR = 0;
    /* 用户代码 */
}

void CPU2_SOFT_IRQ0Handler (void)
{
    SRC_GPSR10.B.SRR = 0;
    /* 用户代码 */
}

void CPU2_SOFT_IRQ1Handler (void)
{
    SRC_GPSR11.B.SRR = 0;
    /* 用户代码 */
}

void CPU2_SOFT_IRQ2Handler (void)
{
    SRC_GPSR12.B.SRR = 0;
    /* 用户代码 */
}

void CPU2_SOFT_IRQ3Handler (void)
{
    SRC_GPSR13.B.SRR = 0;
    /* 用户代码 */
}
/* cpu软中断 */
IFX_INTERRUPT(CPU0_SOFT_IRQ0Handler, 0, CPU0_SOFT_IRQ0_PRIORITY);
IFX_INTERRUPT(CPU0_SOFT_IRQ1Handler, 0, CPU0_SOFT_IRQ1_PRIORITY);
IFX_INTERRUPT(CPU0_SOFT_IRQ2Handler, 0, CPU0_SOFT_IRQ2_PRIORITY);
IFX_INTERRUPT(CPU0_SOFT_IRQ3Handler, 0, CPU0_SOFT_IRQ3_PRIORITY);

IFX_INTERRUPT(CPU1_SOFT_IRQ0Handler, 2, CPU1_SOFT_IRQ0_PRIORITY);
IFX_INTERRUPT(CPU1_SOFT_IRQ1Handler, 2, CPU1_SOFT_IRQ1_PRIORITY);
IFX_INTERRUPT(CPU1_SOFT_IRQ2Handler, 2, CPU1_SOFT_IRQ2_PRIORITY);
IFX_INTERRUPT(CPU1_SOFT_IRQ3Handler, 2, CPU1_SOFT_IRQ3_PRIORITY);

IFX_INTERRUPT(CPU2_SOFT_IRQ0Handler, 3, CPU2_SOFT_IRQ0_PRIORITY);
IFX_INTERRUPT(CPU2_SOFT_IRQ1Handler, 3, CPU2_SOFT_IRQ1_PRIORITY);
IFX_INTERRUPT(CPU2_SOFT_IRQ2Handler, 3, CPU2_SOFT_IRQ2_PRIORITY);
IFX_INTERRUPT(CPU2_SOFT_IRQ3Handler, 3, CPU2_SOFT_IRQ3_PRIORITY);
/** cpu软中断服务函数地址 */
const void *CpuSoftIrqFuncPointer[12] = {&CPU0_SOFT_IRQ0Handler, &CPU0_SOFT_IRQ1Handler, &CPU0_SOFT_IRQ2Handler,
        &CPU0_SOFT_IRQ3Handler, &CPU1_SOFT_IRQ0Handler, &CPU1_SOFT_IRQ1Handler, &CPU1_SOFT_IRQ2Handler,
        &CPU1_SOFT_IRQ3Handler, &CPU2_SOFT_IRQ0Handler, &CPU2_SOFT_IRQ1Handler, &CPU2_SOFT_IRQ2Handler,
        &CPU2_SOFT_IRQ3Handler};

/*************************************************************************
 *  函数名称：GPSR_InitConfig(IfxSrc_Tos cpu, uint8 softIrq)
 *  功能说明：软件中的初始化
 *  参数说明：cpu     ： IfxSrc_Tos_cpu0   IfxSrc_Tos_cpu1
 *  参数说明：softIrq ： 每个CPU有4个软件中断, irq序号
 *  函数返回：无
 *  修改时间：2020年5月6日
 *  备    注：
 *************************************************************************/
void GPSR_InitConfig (IfxSrc_Tos cpu, SOFT_IRQ index)
{
    /* 关闭中断 */
    boolean interruptState = IfxCpu_disableInterrupts();

    uint8 temp = cpu * 4 + index;
    SRC_GPSR00.B.SRR = 0;
    SRC_GPSR01.B.SRR = 0;
    SRC_GPSR02.B.SRR = 0;
    SRC_GPSR03.B.SRR = 0;

    SRC_GPSR04.B.SRR = 0;
    SRC_GPSR05.B.SRR = 0;
    SRC_GPSR06.B.SRR = 0;
    SRC_GPSR07.B.SRR = 0;

    SRC_GPSR10.B.SRR = 0;
    SRC_GPSR11.B.SRR = 0;
    SRC_GPSR12.B.SRR = 0;
    SRC_GPSR13.B.SRR = 0;

    /* 开启中断 */
    volatile Ifx_SRC_SRCR *src = &MODULE_SRC.GPSR.GPSR[(int) cpu].SR[0];
    IfxSrc_init(src, (int) cpu, (uint32) CpuSoftIrqPriority[temp]);
    IfxSrc_enable(src);

    src = &MODULE_SRC.GPSR.GPSR[(int) cpu].SR[1];
    IfxSrc_init(src, (int) cpu, (uint32) CpuSoftIrqPriority[temp]);
    IfxSrc_enable(src);

    src = &MODULE_SRC.GPSR.GPSR[(int) cpu].SR[2];
    IfxSrc_init(src, (int) cpu, (uint32) CpuSoftIrqPriority[temp]);
    IfxSrc_enable(src);

    src = &MODULE_SRC.GPSR.GPSR[(int) cpu].SR[3];
    IfxSrc_init(src, (int) cpu, (uint32) CpuSoftIrqPriority[temp]);
    IfxSrc_enable(src);

    /* 安装中断服务函数 */
    IfxCpu_Irq_installInterruptHandler((void*) CpuSoftIrqFuncPointer[temp], (uint32) CpuSoftIrqPriority[temp]);

    /* 开启中断 */
    IfxCpu_restoreInterrupts(interruptState);
}

/*************************************************************************
 *  函数名称：CPSR_Trig(IfxSrc_Tos cpu, uint8 softIrq)
 *  功能说明：触发软件中断
 *  参数说明：cpu     ： IfxSrc_Tos_cpu0   IfxSrc_Tos_cpu1
 *  参数说明：softIrq ： 每个CPU有4个软件中断, irq序号
 *  函数返回：无
 *  修改时间：2020年5月6日
 *  备    注：
 *************************************************************************/
void CPSR_Trig (IfxSrc_Tos cpu, SOFT_IRQ index)
{
    if (cpu == IfxSrc_Tos_cpu0)
    {
        INT_SRB0.U = 1 << (uint8) index;
    }
    else
    {
        INT_SRB1.U = 1 << (uint8) index;
    }
}
