Kaoru-dev/Wireless-Charging-Car-with-Acoustic-Source-Localization/Code/src/AppSw/Tricore/APP/LQ_FFT_TEST.c

/*LLLLLLLLLLLLLLLLLLLLLLLLLLLLLLLLLLLLLLLLLLLLLLLLLLLLLLLLLLLLLL
【平    台】北京龙邱智能科技TC3xxxA核心板
【编    写】chiusir
【E-mail】chiusir@163.com
【软件版本】V1.1 版权所有，单位使用请先联系授权
【最后更新】2020年10月28日
【相关信息参考下列地址】
【网    站】http://www.lqist.cn
【淘宝店铺】http://longqiu.taobao.com
------------------------------------------------
【dev.env.】AURIX Development Studio1.2.2及以上版本
【Target 】 TC3xxxA
【Crystal】 20.000Mhz
【SYS PLL】 300MHz
________________________________________________________________
基于iLLD_1_0_1_11_0底层程序,
使用例程的时候，建议采用没有空格的英文路径，
=================================================================
程序配套视频地址：https://space.bilibili.com/95313236
QQQQQQQQQQQQQQQQQQQQQQQQQQQQQQQQQQQQQQQQQQQQQQQQQQQQQQQQQQQQQQQ*/

#include <Ifx_FftF32.h>
#include <LQ_FFT_TEST.h>
#include <LQ_GPIO_LED.h>
#include <stdio.h>
#include <ANO_DT.h>
//#include <LQ_FFT.h>

/* matlab 代码  可以对比fft的结果
Fs = 1024;            % Sampling frequency
T = 1/Fs;             % Sampling period
L = 1024;             % Length of signal
t = (0:L-1)*T;        % Time vector
S = 70*sin(2*pi*50*t) + 100*sin(2*pi*120*t);
f = Fs*(0:(L/2))/L;
Y = fft(S);
P2 = abs(Y/L);
P1 = P2(1:L/2+1);
P1(2:end-1) = 2*P1(2:end-1);
hold off
plot(f,P1)
title('Single-Sided Amplitude Spectrum of S(t)')
xlabel('f (Hz)')
ylabel('|P1(f)|')
hold on
plot(1000*t(1:50),S(1:50))
title('Signal Corrupted with Zero-Mean Random Noise')
xlabel('t (milliseconds)')
ylabel('X(t)')
 */

/////////////////////////////////////////////////////////////////////////////////////
//////////////////////////////////以下部分为功能测试/////////////////////////////////
/////////////////////////////////////////////////////////////////////////////////////

/*

//IFFT变换结果，必须256位对齐
IFX_ALIGN(256)  csint32 ifftOut[1024];

//源波形，必须256位对齐
IFX_ALIGN(256)  sint16 fftIn[1024];

//FFT变换结果，必须256位对齐
IFX_ALIGN(256)  csint32 fftOut[1024];
*/
/*************************************************************************
*  函数名称：void Test_FFT(void)
*  功能说明：测试FFT变换
*  参数说明：无
*  函数返回：无
*  修改时间：2020年4月20日
*  备    注：测试FFT变换和IFFT变换    注意  硬件FFT需要TC264 DA的芯片才有此功能
*************************************************************************/
/*
void Test_FFT(void)
{
    unsigned short Fs = 1024;    //信号频率

    float    T  = 1.0f/Fs; //信号周期

    unsigned short L  = 1024;    //长度

    // 做一个50Hz和120Hz的正玄叠加信号
    int i = 0;
    for(i = 0; i < L; i++)
    {
        fftIn[i] = 70*sin(2*IFX_PI*50*T*i) + 100*sin(2*IFX_PI*120*T*i);
    }


    while(1)
    {
        // 初始化为 FFT  注意 这里FFT输出结果是实际结果的64倍
        FFT_InitConfig((uint32)fftIn, (uint32)fftOut, IfxFft_Length_1024);

        FFT_Start();

        //初始化为 IFFT
        IFFT_InitConfig((uint32)fftOut, (uint32)ifftOut, IfxFft_Length_1024);

        FFT_Start();

        LED_Ctrl(LED0,RVS);               //电平翻转,LED闪烁

    }
}

*/
//源波形，256位对齐
IFX_ALIGN(256) cfloat32 sfftIn[1024];

//IFFT变换结果，256位对齐
IFX_ALIGN(256) cfloat32 sifftOut[1024];

//FFT变换结果，256位对齐
IFX_ALIGN(256) cfloat32 sfftOut[1024];

/*************************************************************************
*  函数名称：void Test_SoftFft(void)
*  功能说明：测试软件FFT变换
*  参数说明：无
*  函数返回：无
*  修改时间：2020年4月20日
*  备    注：测试FFT变换和IFFT变换    注意  所有TC264 芯片都可以
*************************************************************************/
void Test_SoftFft(void)
{
    cfloat32 sfftIn[4096];

    //IFFT变换结果，256位对齐
     cfloat32 sifftOut[4096];

    //FFT变换结果，256位对齐
     cfloat32 sfftOut[4096];

    unsigned short Fs = 1024;    //

    float    T  = 1.0f/Fs; //

    unsigned short L  = 2048;    //

    /*  */
    int i = 0;
    for(i = 0; i < L; i++)
    {
        sfftIn[i].real = 10000*sin(2*IFX_PI*50*T*i) + 10000*sin(2*IFX_PI*120*T*i);
        sfftIn[i].imag= sfftIn[i+2048].real=sfftIn[i+2048].imag= 0;
    }

    while(1)
    {
        //FFT
        Ifx_FftF32_radix2(sfftOut, sfftIn, 4096);
        ANO_DT_send_int16(50,sfftOut[500].imag,sfftOut[1000].real,sfftOut[1000].imag,sfftOut[2000].real,sfftOut[2000].imag,sfftOut[3000].real,sfftOut[3000].imag);

        //IFFT
        Ifx_FftF32_radix2I(sifftOut, sfftOut, 4096);
        //ANO_DT_send_int16(50,sifftOut[500].imag,sifftOut[1000].real,sifftOut[1000].imag,sifftOut[2000].real,sifftOut[2000].imag,sifftOut[3000].real,sifftOut[3000].imag);

        //LED_Ctrl(LED0,RVS);               //

    }
}
